jut-a/esphome-max7219-hottub/hardware/case/grid_right.stl

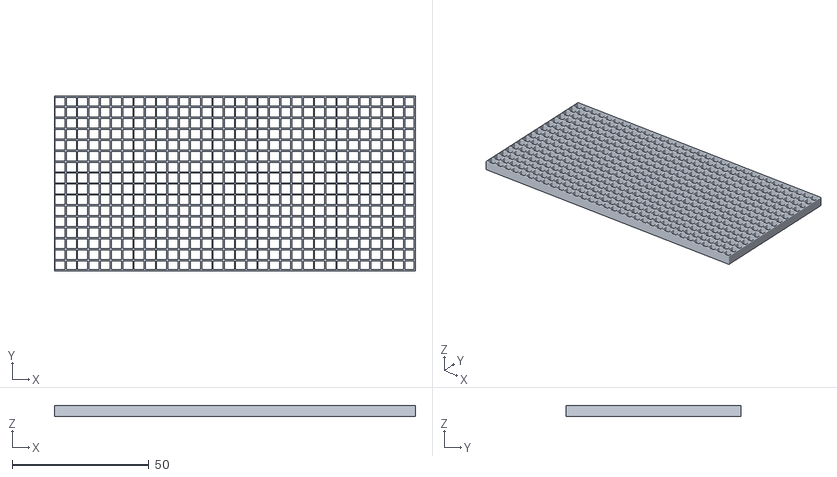
[picture p11: CAD file, 2026-11-12]
hardware/case/grid_right.stl
132.0 x 64.0 x 4.00
