jut-a/esphome-max7219-hottub/hardware/case/lid_left.stl

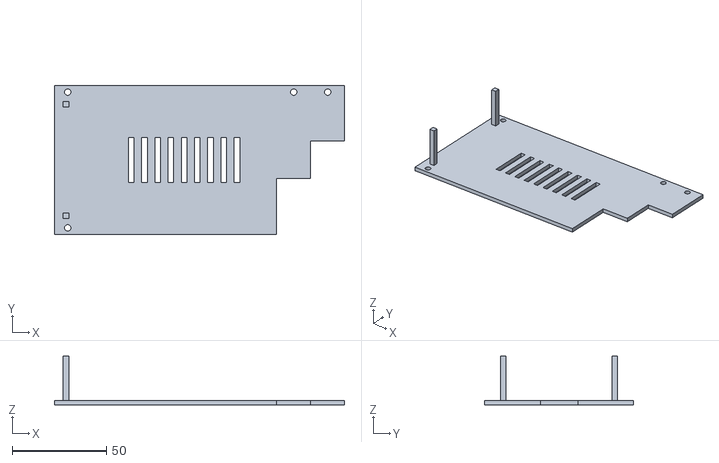
[picture p12: CAD file, 2026-11-12]
hardware/case/lid_left.stl
153.5 x 78.8 x 25.9
