jut-a/esphome-max7219-hottub/hardware/case/foot.stl

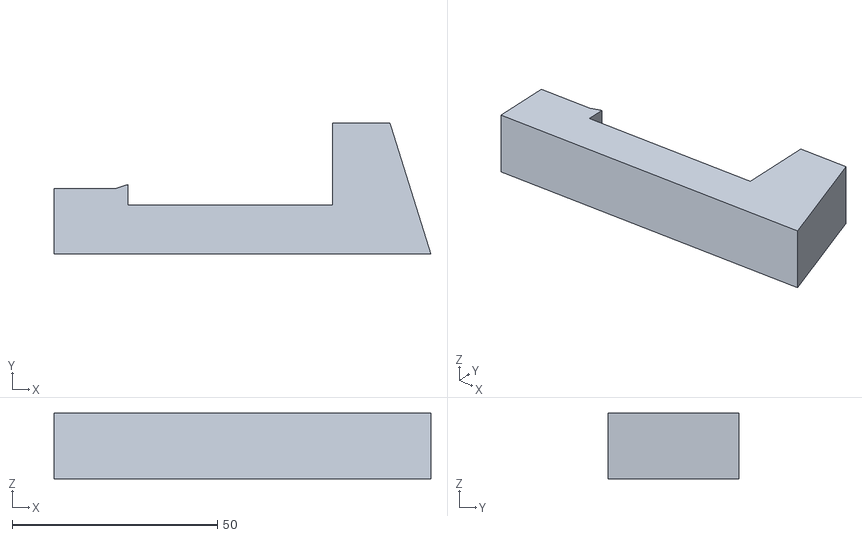
[picture p13: CAD file, 2026-11-12]
hardware/case/foot.stl
91.9 x 32.0 x 16.0
