jut-a/esphome-max7219-hottub/hardware/case/skin_grid_left.stl

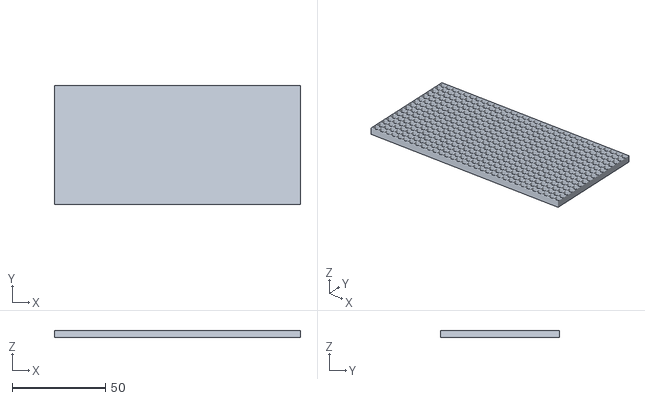
[picture p14: CAD file, 2026-11-12]
hardware/case/skin_grid_left.stl
132.0 x 64.0 x 4.00
