jut-a/esphome-max7219-hottub/hardware/case/body.stl

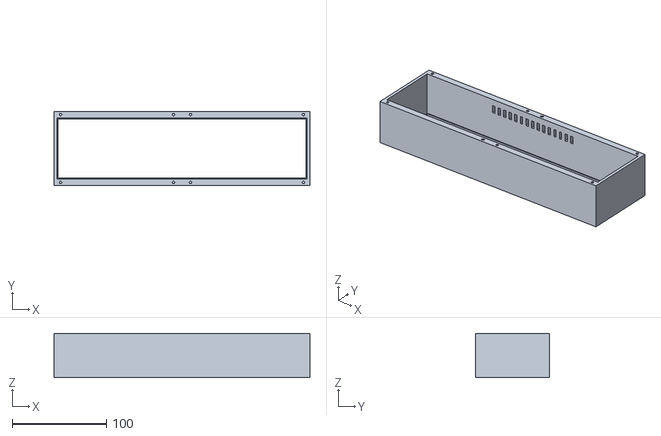
[picture p16: CAD file, 2026-11-12]
hardware/case/body.stl
271.2 x 78.8 x 46.9
