jut-a/esphome-max7219-hottub/hardware/case/fit_test.stl

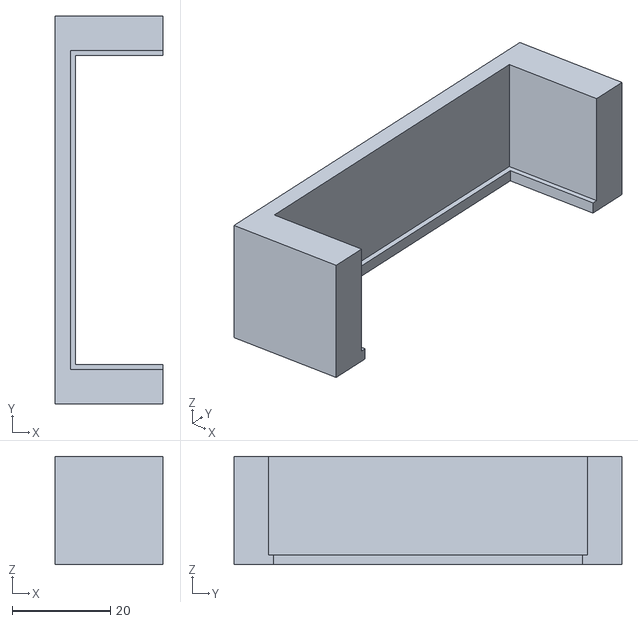
[picture p17: CAD file, 2026-11-12]
hardware/case/fit_test.stl
22.0 x 78.8 x 22.0
