jut-a/esphome-max7219-hottub/hardware/case/body_right.stl

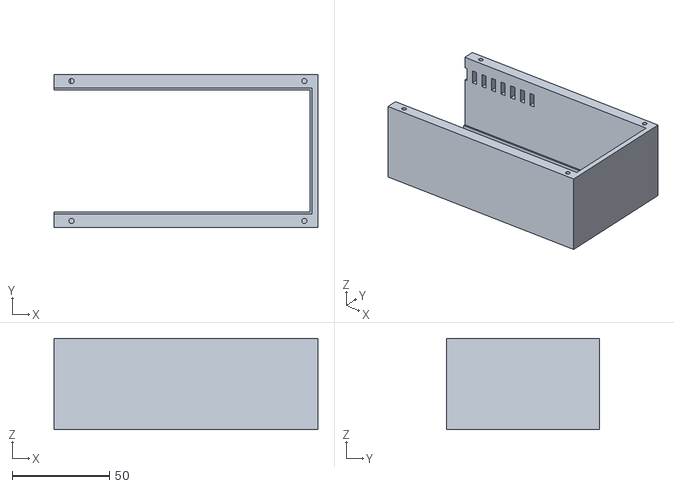
[picture p18: CAD file, 2026-11-12]
hardware/case/body_right.stl
135.6 x 78.8 x 46.9
