jut-a/esphome-max7219-hottub/hardware/case/lid.stl

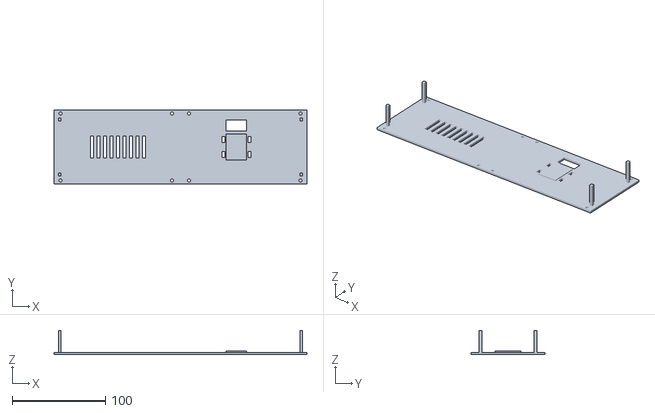
[picture p19: CAD file, 2026-11-12]
hardware/case/lid.stl
271.2 x 78.8 x 25.9
