jut-a/esphome-max7219-hottub/hardware/case/skin_grid.stl

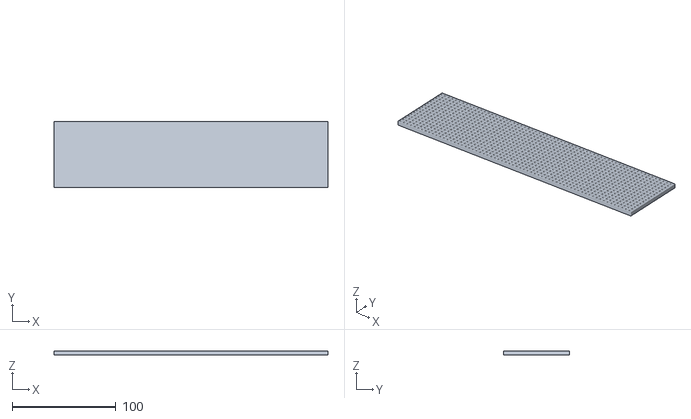
[picture p20: CAD file, 2026-11-12]
hardware/case/skin_grid.stl
264.0 x 64.0 x 4.00
