jut-a/esphome-max7219-hottub/hardware/case/grid_test.stl

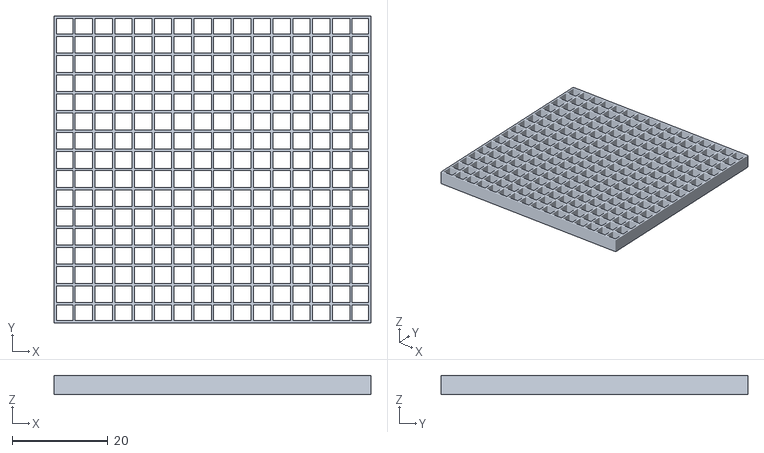
[picture p21: CAD file, 2026-11-12]
hardware/case/grid_test.stl
66.0 x 64.0 x 4.00
