jut-a/esphome-max7219-hottub/hardware/case/keys.stl

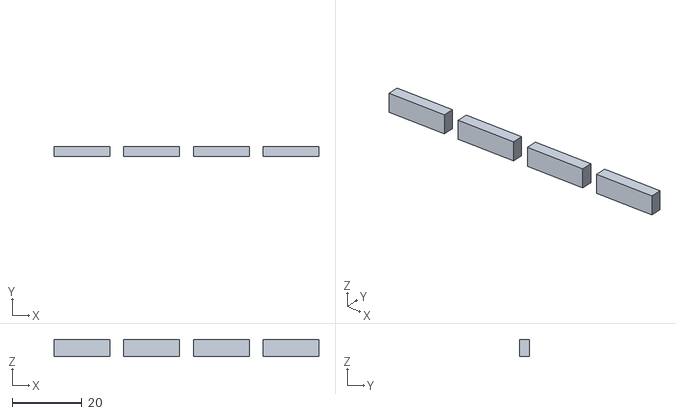
[picture p22: CAD file, 2026-11-12]
hardware/case/keys.stl
76.0 x 3.00 x 5.00
