jut-a/esphome-max7219-hottub/(list of files, cad)

Other CAD files:
hardware/case/lid_right.stl
hardware/case/grid_left.stl
hardware/case/body_left.stl
hardware/case/skin_grid_right.stl
